Wiles/iv-12/README.md

# iv-12

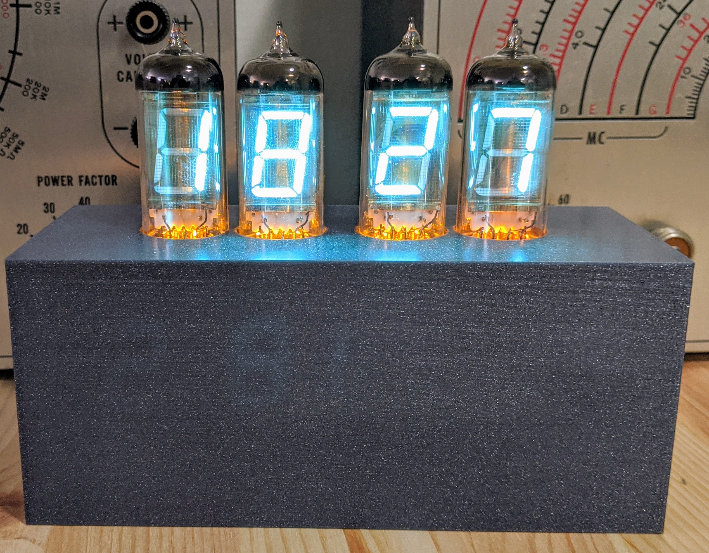
[picture p1: iv12.jpg]
iv12


File for the case are available at: https://www.thingiverse.com/thing:4103417
