Wiles/iv-12/clock/clock.kicad_pcb

## KiCad design clock/clock.kicad_pcb (2019-03-26)

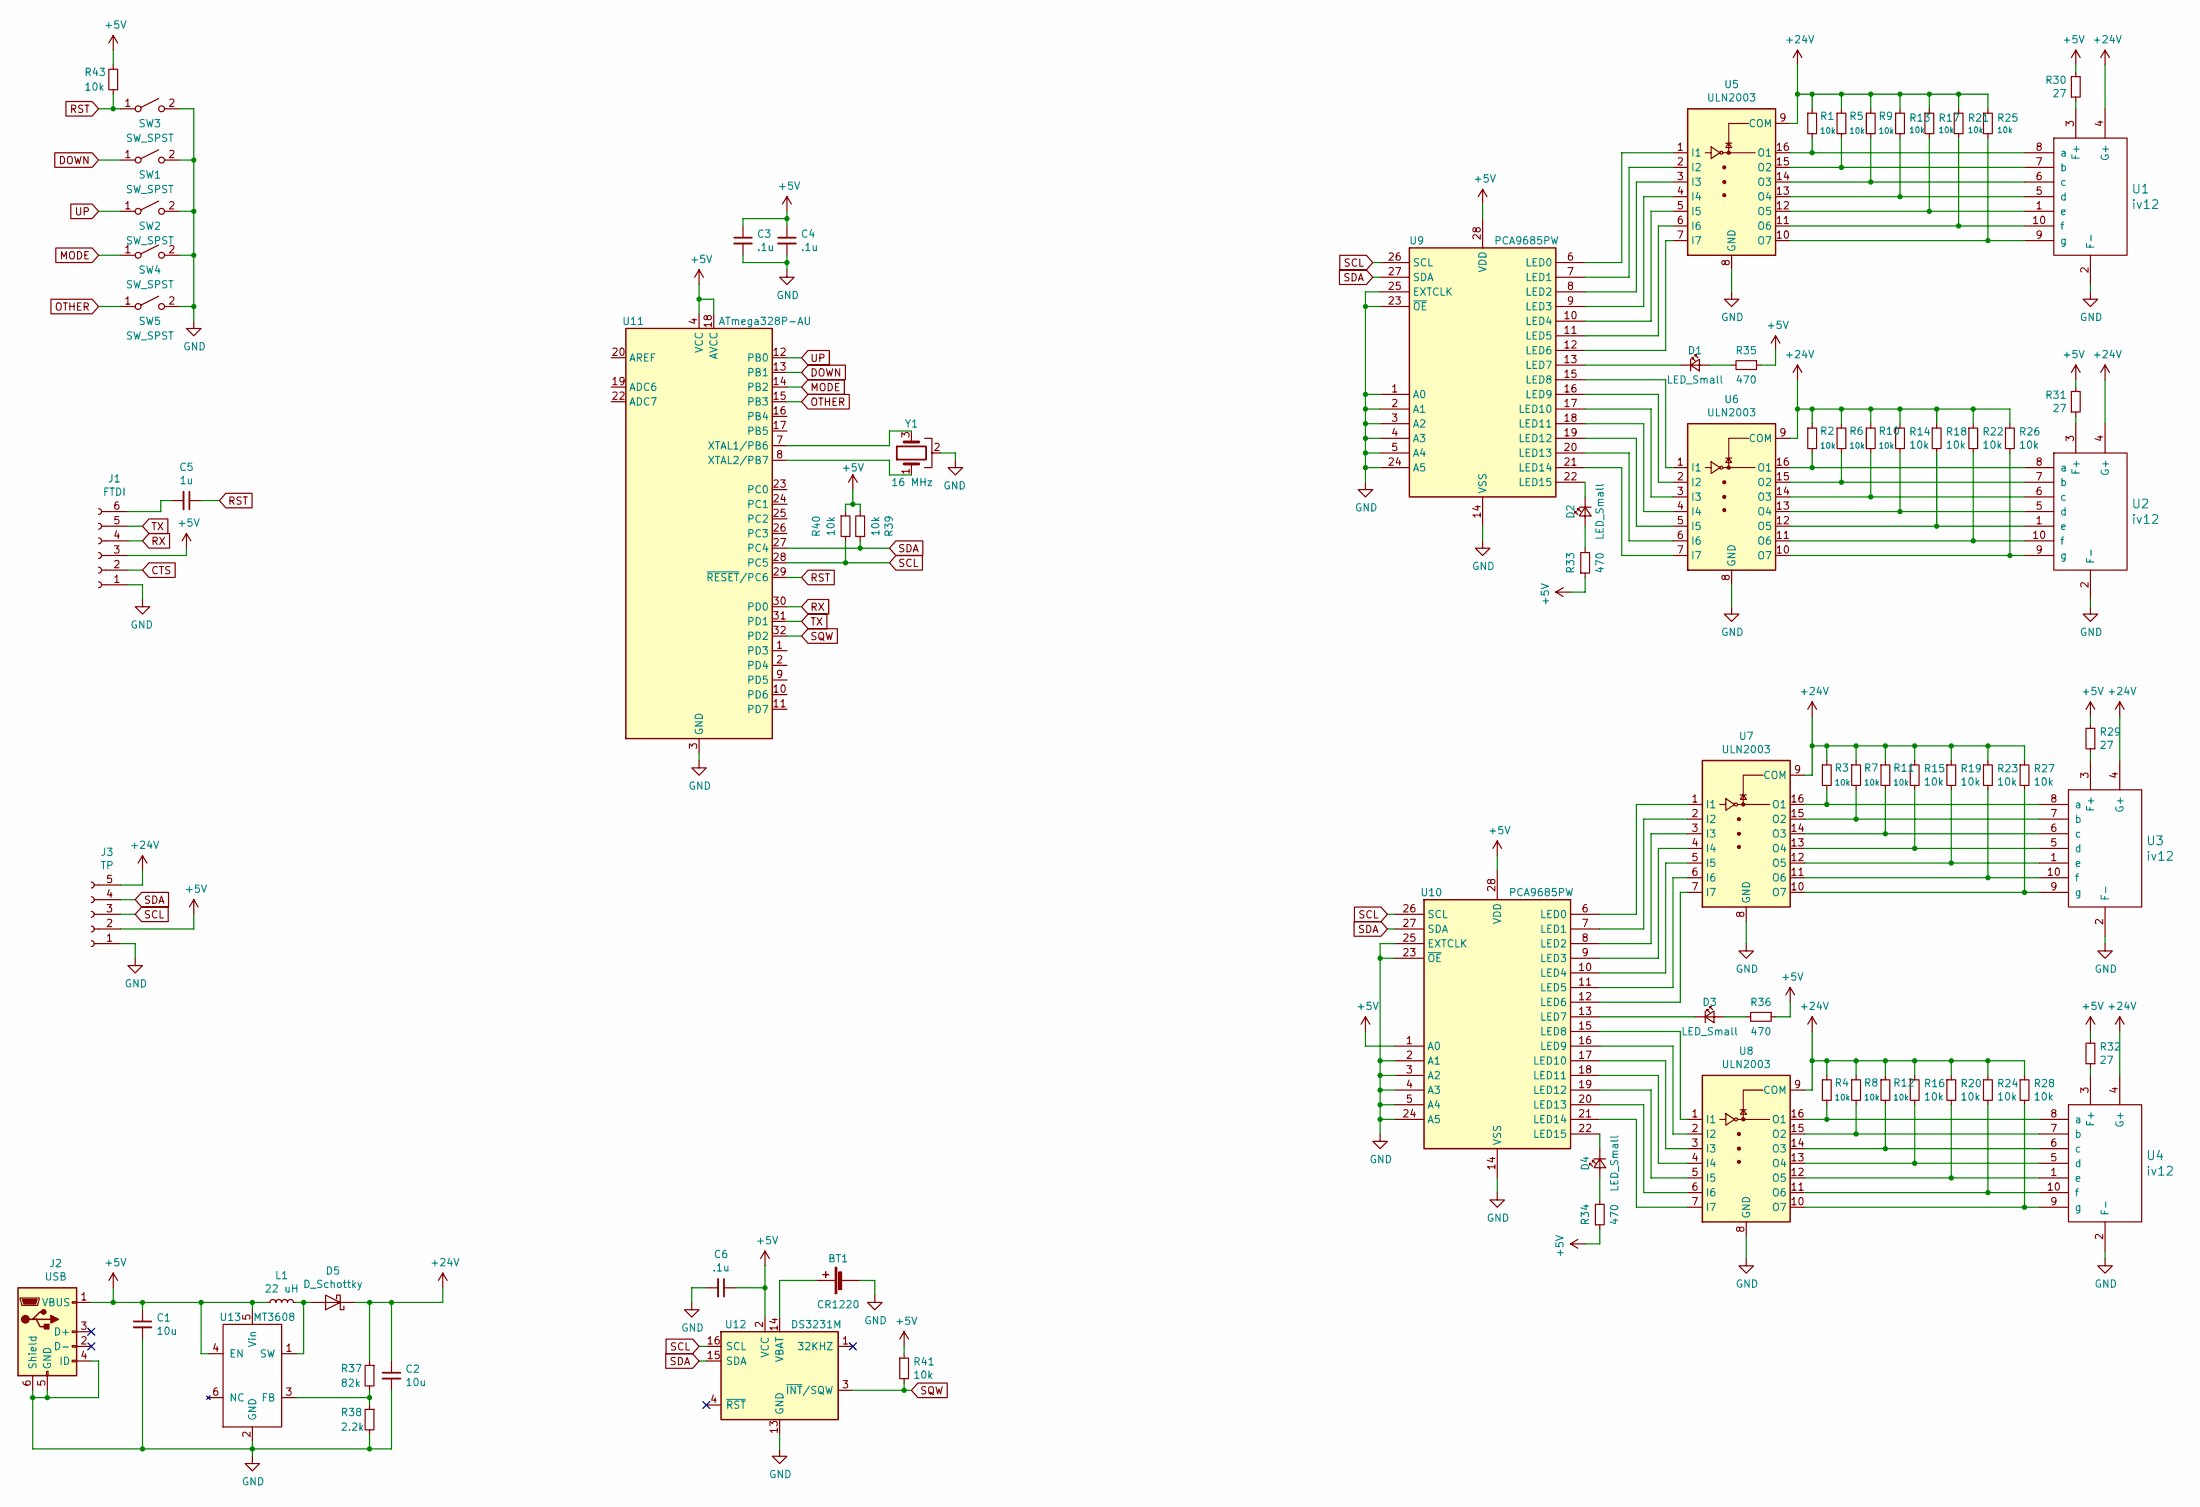
[picture p2: schematic clock.sch]

Parts:
BT1: CR1220; BatteryHolder_Keystone_3000_1x12mm
C1, C2: 10u; C_1206_3216Metric_Pad1.42x1.75mm_HandSolder
C3, C4, C6: .1u; C_0603_1608Metric_Pad1.05x0.95mm_HandSolder
C5: 1u; C_0603_1608Metric_Pad1.05x0.95mm_HandSolder
D1, D2, D3, D4: LED_Small; LED_0805_2012Metric_Pad1.15x1.40mm_HandSolder
D5: D_Schottky; D_SMA
J1: FTDI; PinHeader_1x06_P2.54mm_Vertical
J2: USB; USB_Micro-B_Wuerth_614105150721_Vertical
J3: TP; PinHeader_1x05_P2.54mm_Vertical
L1: 22 uH; L_10.4x10.4_H4.8
R1, R2, R3, R4, R5, R6, R7, R8, R9, R10, R11, R12, R13, R14, R15, R16, R17, R18, R19, R20, R21, R22, R23, R24, R25, R26, R27, R28, R39, R40, R41, R43: 10k; R_0603_1608Metric_Pad1.05x0.95mm_HandSolder
R29, R30, R31, R32: 27; R_0603_1608Metric_Pad1.05x0.95mm_HandSolder
R33, R34, R35, R36: 470; R_0603_1608Metric_Pad1.05x0.95mm_HandSolder
R37: 82k; R_0603_1608Metric_Pad1.05x0.95mm_HandSolder
R38: 2.2k; R_0603_1608Metric_Pad1.05x0.95mm_HandSolder
SW1, SW2, SW3, SW4, SW5: SW_SPST; SW_SPST_TL3342
U1, U2, U3, U4: iv12; iv12-large
U5, U6, U7, U8: ULN2003; SOIC-16_3.9x9.9mm_P1.27mm
U9, U10: PCA9685PW; TSSOP-28_4.4x9.7mm_P0.65mm
U11: ATmega328P-AU; TQFP-32_7x7mm_P0.8mm
U12: DS3231M; SOIC-16W_7.5x10.3mm_P1.27mm
U13: MT3608; SOT-23-6_Handsoldering
Y1: 16 MHz; Resonator_SMD_muRata_CSTxExxV-3Pin_3.0x1.1mm_HandSoldering

Connections:
+5V: C1.1, C3.1, C4.1, C6.1, J1.3, J2.1 (VBUS), J3.2, L1.1, R29.2, R30.2, R31.2, R32.2, R33.1, R34.1, R35.1, R36.1, R39.2, R40.1, R41.1, R43.2, U9.28 (VDD), U10.1 (A0), U10.28 (VDD), U11.4 (VCC), U11.6 (VCC), U11.18 (AVCC), U12.2 (VCC), U13.4 (EN), U13.5 (Vin)
+24V: C2.1, D5.1 (K), J3.5, R1.1, R2.1, R3.1, R4.1, R5.1, R6.1, R7.1, R8.1, R9.1, R10.1, R11.1, R12.1, R13.1, R14.1, R15.1, R16.1, R17.1, R18.1, R19.1, R20.1, R21.1, R22.1, R23.1, R24.1, R25.1, R26.1, R27.1, R28.1, R37.1, U1.4 (G+), U2.4 (G+), U3.4 (G+), U4.4 (G+), U5.9 (COM), U6.9 (COM), U7.9 (COM), U8.9 (COM)
CTS: J1.2
DOWN: SW1.1 (A), U11.13 (PB1)
GND: BT1.2 (-), C1.2, C2.2, C3.2, C4.2, C6.2, J1.1, J2.4 (ID), J2.5 (GND), J2.6 (Shield), J3.1, R38.2, SW1.2 (B), SW2.2 (B), SW3.2 (B), SW4.2 (B), SW5.2 (B), U1.2 (F-), U2.2 (F-), U3.2 (F-), U4.2 (F-), U5.8 (GND), U6.8 (GND), U7.8 (GND), U8.8 (GND), U9.1 (A0), U9.2 (A1), U9.3 (A2), U9.4 (A3), U9.5 (A4), U9.14 (VSS), U9.23 (~OE), U9.24 (A5), U9.25 (EXTCLK), U10.2 (A1), U10.3 (A2), U10.4 (A3), U10.5 (A4), U10.14 (VSS), U10.23 (~OE), U10.24 (A5), U10.25 (EXTCLK), U11.3 (GND), U11.5 (GND), U11.21 (GND), U12.5 (GND), U12.6 (GND), U12.7 (GND), U12.8 (GND), U12.9 (GND), U12.10 (GND), U12.11 (GND), U12.12 (GND), U12.13 (GND), U13.2 (GND), Y1.2
MODE: SW4.1 (A), U11.14 (PB2)
unnamed: BT1.1 (+), U12.14 (VBAT)
unnamed: C5.2, J1.6
unnamed: D1.1 (K), U9.13 (LED7)
unnamed: D1.2 (A), R35.2
unnamed: D2.1 (K), U9.22 (LED15)
unnamed: D2.2 (A), R33.2
unnamed: D3.1 (K), U10.13 (LED7)
unnamed: D3.2 (A), R36.2
unnamed: D4.1 (K), U10.22 (LED15)
unnamed: D4.2 (A), R34.2
unnamed: D5.2 (A), L1.2, U13.1 (SW)
unnamed: R1.2, U1.8 (a), U5.16 (O1)
unnamed: R2.2, U2.8 (a), U6.16 (O1)
unnamed: R3.2, U3.8 (a), U7.16 (O1)
unnamed: R4.2, U4.8 (a), U8.16 (O1)
unnamed: R5.2, U1.7 (b), U5.15 (O2)
unnamed: R6.2, U2.7 (b), U6.15 (O2)
unnamed: R7.2, U3.7 (b), U7.15 (O2)
unnamed: R8.2, U4.7 (b), U8.15 (O2)
unnamed: R9.2, U1.6 (c), U5.14 (O3)
unnamed: R10.2, U2.6 (c), U6.14 (O3)
unnamed: R11.2, U3.6 (c), U7.14 (O3)
unnamed: R12.2, U4.6 (c), U8.14 (O3)
unnamed: R13.2, U1.5 (d), U5.13 (O4)
unnamed: R14.2, U2.5 (d), U6.13 (O4)
unnamed: R15.2, U3.5 (d), U7.13 (O4)
unnamed: R16.2, U4.5 (d), U8.13 (O4)
unnamed: R17.2, U1.1 (e), U5.12 (O5)
unnamed: R18.2, U2.1 (e), U6.12 (O5)
unnamed: R19.2, U3.1 (e), U7.12 (O5)
unnamed: R20.2, U4.1 (e), U8.12 (O5)
unnamed: R21.2, U1.10 (f), U5.11 (O6)
unnamed: R22.2, U2.10 (f), U6.11 (O6)
unnamed: R23.2, U3.10 (f), U7.11 (O6)
unnamed: R24.2, U4.10 (f), U8.11 (O6)
unnamed: R25.2, U1.9 (g), U5.10 (O7)
unnamed: R26.2, U2.9 (g), U6.10 (O7)
unnamed: R27.2, U3.9 (g), U7.10 (O7)
unnamed: R28.2, U4.9 (g), U8.10 (O7)
unnamed: R29.1, U3.3 (F+)
unnamed: R30.1, U1.3 (F+)
unnamed: R31.1, U2.3 (F+)
unnamed: R32.1, U4.3 (F+)
unnamed: R37.2, R38.1, U13.3 (FB)
unnamed: U5.1 (I1), U9.6 (LED0)
unnamed: U5.2 (I2), U9.7 (LED1)
unnamed: U5.3 (I3), U9.8 (LED2)
unnamed: U5.4 (I4), U9.9 (LED3)
unnamed: U5.5 (I5), U9.10 (LED4)
unnamed: U5.6 (I6), U9.11 (LED5)
unnamed: U5.7 (I7), U9.12 (LED6)
unnamed: U6.1 (I1), U9.15 (LED8)
unnamed: U6.2 (I2), U9.16 (LED9)
unnamed: U6.3 (I3), U9.17 (LED10)
unnamed: U6.4 (I4), U9.18 (LED11)
unnamed: U6.5 (I5), U9.19 (LED12)
unnamed: U6.6 (I6), U9.20 (LED13)
unnamed: U6.7 (I7), U9.21 (LED14)
unnamed: U7.1 (I1), U10.6 (LED0)
unnamed: U7.2 (I2), U10.7 (LED1)
unnamed: U7.3 (I3), U10.8 (LED2)
unnamed: U7.4 (I4), U10.9 (LED3)
unnamed: U7.5 (I5), U10.10 (LED4)
unnamed: U7.6 (I6), U10.11 (LED5)
unnamed: U7.7 (I7), U10.12 (LED6)
unnamed: U8.1 (I1), U10.15 (LED8)
unnamed: U8.2 (I2), U10.16 (LED9)
unnamed: U8.3 (I3), U10.17 (LED10)
unnamed: U8.4 (I4), U10.18 (LED11)
unnamed: U8.5 (I5), U10.19 (LED12)
unnamed: U8.6 (I6), U10.20 (LED13)
unnamed: U8.7 (I7), U10.21 (LED14)
unnamed: U11.7 (XTAL1/PB6), Y1.3
unnamed: U11.8 (XTAL2/PB7), Y1.1
OTHER: SW5.1 (A), U11.15 (PB3)
RST: C5.1, R43.1, SW3.1 (A), U11.29 (~RESET~/PC6)
RX: J1.4, U11.30 (PD0)
SCL: J3.3, R40.2, U9.26 (SCL), U10.26 (SCL), U11.28 (PC5), U12.16 (SCL)
SDA: J3.4, R39.1, U9.27 (SDA), U10.27 (SDA), U11.27 (PC4), U12.15 (SDA)
SQW: R41.2, U11.32 (PD2), U12.3 (~INT~/SQW)
TX: J1.5, U11.31 (PD1)
UP: SW2.1 (A), U11.12 (PB0)

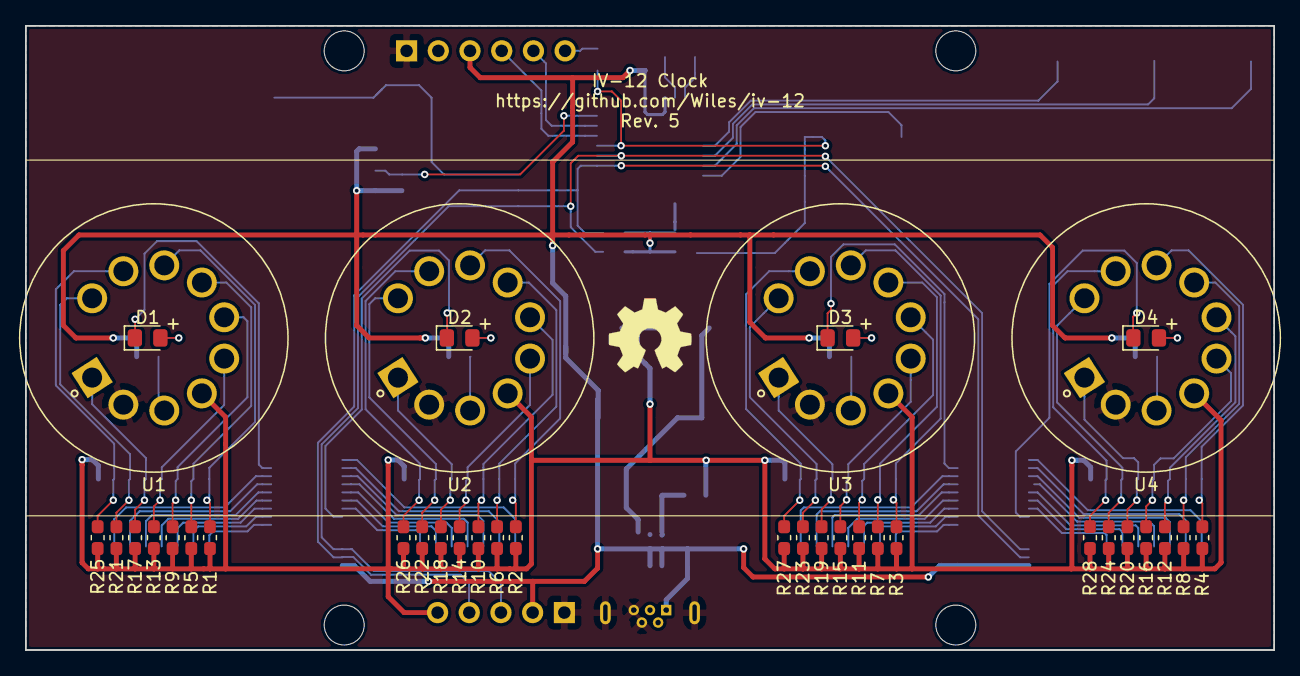
[picture p3: board clock.kicad_pcb from above]

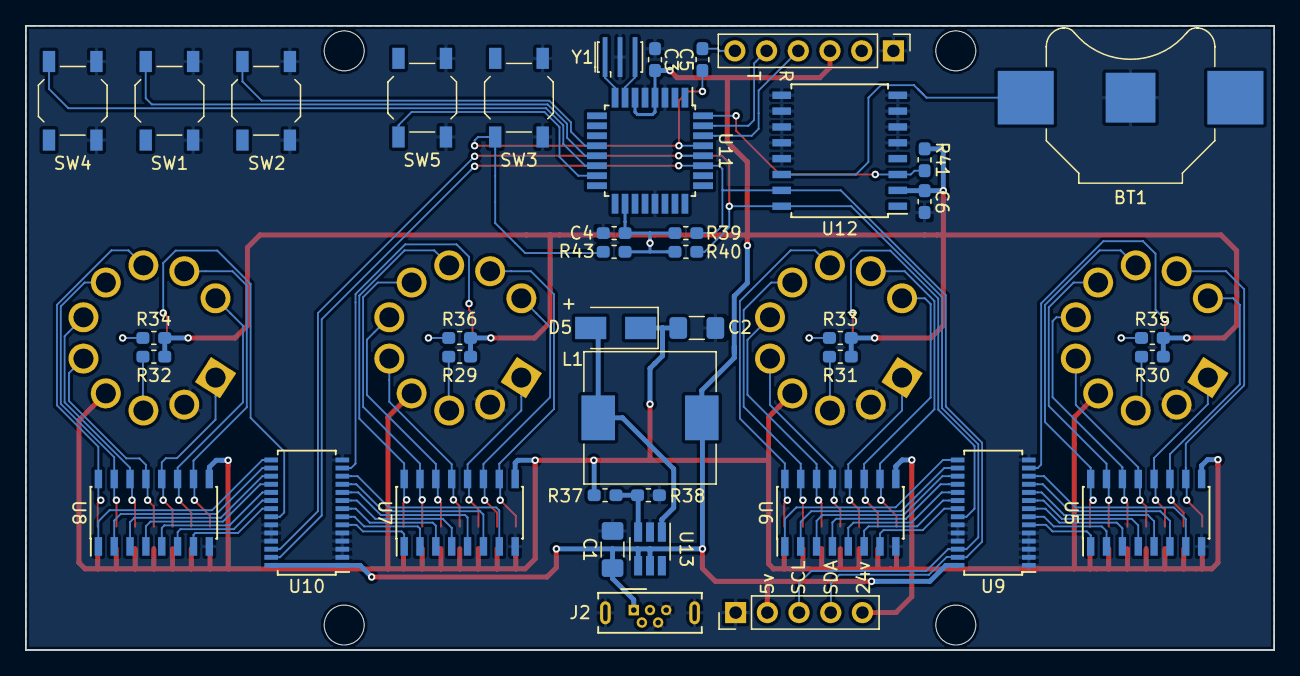
[picture p4: board clock.kicad_pcb from below]

Board: 2 copper layers, 100.0 x 50.0 mm, 77 parts (41 on the bottom side), 87 nets.
