Wiles/iv-12/iv12.kicad_pcb

## KiCad design iv12.kicad_pcb (2018-03-15)

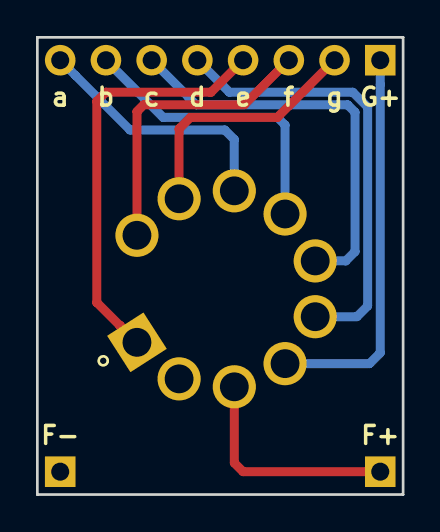
[picture p5: board iv12.kicad_pcb from above]

Board: 2 copper layers, 20.3 x 25.4 mm, 4 parts (0 on the bottom side), 10 nets.

Parts:
J1: CONN_01X08; Pin_Header_Straight_1x08_Pitch2.54mm
J2, J3: CONN_01X01; Pin_Header_Straight_1x01_Pitch2.54mm
U1: iv12; iv12-large

Connections:
+1V5: J3.1, U1.3
+24V: J1.1, U1.4
GND: J2.1, U1.2
unnamed: J1.2, U1.9
unnamed: J1.3, U1.10
unnamed: J1.4, U1.1
unnamed: J1.5, U1.5
unnamed: J1.6, U1.6
unnamed: J1.7, U1.7
unnamed: J1.8, U1.8
