Wiles/iv-12/(commit log)

2018-02-23 Breakout board for iv-12 tube
    [iv12.kicad_pcb, iv12.sch]
2018-02-24 Renamed filament ground pin to F-
2018-02-25 Start of clock circuit
    [clock.kicad_pcb, clock.sch]
2018-02-25 Start of power design
    [clock.kicad_pcb, clock.sch]
2018-02-25 Arduino code playing around with RTC and HV5812 based display
2018-02-27 Added SVG of current layout
2018-02-27 Moved around power features
    [clock.kicad_pcb, clock.sch]
2018-03-15 Breakout board rev 2. Improved input and used larger holes for tube.
2018-03-15 Files missed from last commit.
    [iv12.kicad_pcb, iv12.sch]
2018-03-15 Made labels for segments lowercase to reduce confusion it G and G+
    [iv12.kicad_pcb]
2018-12-02 Rev 1 of clock display board
    [_saved_clock.sch, clock.kicad_pcb]
2018-12-02 Schematic files for clock display pcb
    [_saved_clock.sch, clock.sch]
2018-12-31 Clock rev 2 with controller
    [clock.kicad_pcb, clock.sch]
2019-01-27 Rev 3 pcb
    [clock.kicad_pcb, clock.sch]
2019-01-27 Fixed silkscreen
    [clock.kicad_pcb]
2019-02-18 Rev 4 PCB
    [clock.kicad_pcb, clock.sch]
2019-02-18 Readded OSHW logo
    [clock.kicad_pcb]
2019-02-19 Layout cleanup
    [clock.kicad_pcb]
2019-02-19 Hooked up SQW from RTC to MCU
    [clock.kicad_pcb, clock.sch]
2019-02-19 More cleanup
    [clock.kicad_pcb, clock.sch]
2019-02-19 Moved 24v test point
    [clock.kicad_pcb, clock.sch]
2019-02-24 Added diode polarity marks
    [clock.kicad_pcb]
2019-02-24 Fixed D5 mark layer
    [clock.kicad_pcb]
2019-02-25 Clean up
    [clock.kicad_pcb, clock.sch]
2019-03-17 Fixed crystal pinout
    [clock.kicad_pcb, clock.sch]
2019-03-22 Changed USB footprint
    [clock.kicad_pcb, clock.sch]
2019-03-22 Label Tx and Rx pins
    [clock.kicad_pcb]
2019-03-25 Added capacitor to reset line
    [_saved_clock.sch, clock.kicad_pcb]
2019-03-25 Refilled zones
    [clock.kicad_pcb]
2019-03-26 Fixed C3 and C5 labels
    [clock.kicad_pcb]
2019-03-26 Rev 5 PCB
    [clock.kicad_pcb]
2019-07-12 Swapped plus and minus button
    [clock.ino]
